ribbotson/EMG_ADS131M08/Kicad/ADS131M08 ESP32.kicad_pcb

## KiCad design Kicad/ADS131M08 ESP32.kicad_pcb (2023-05-13)

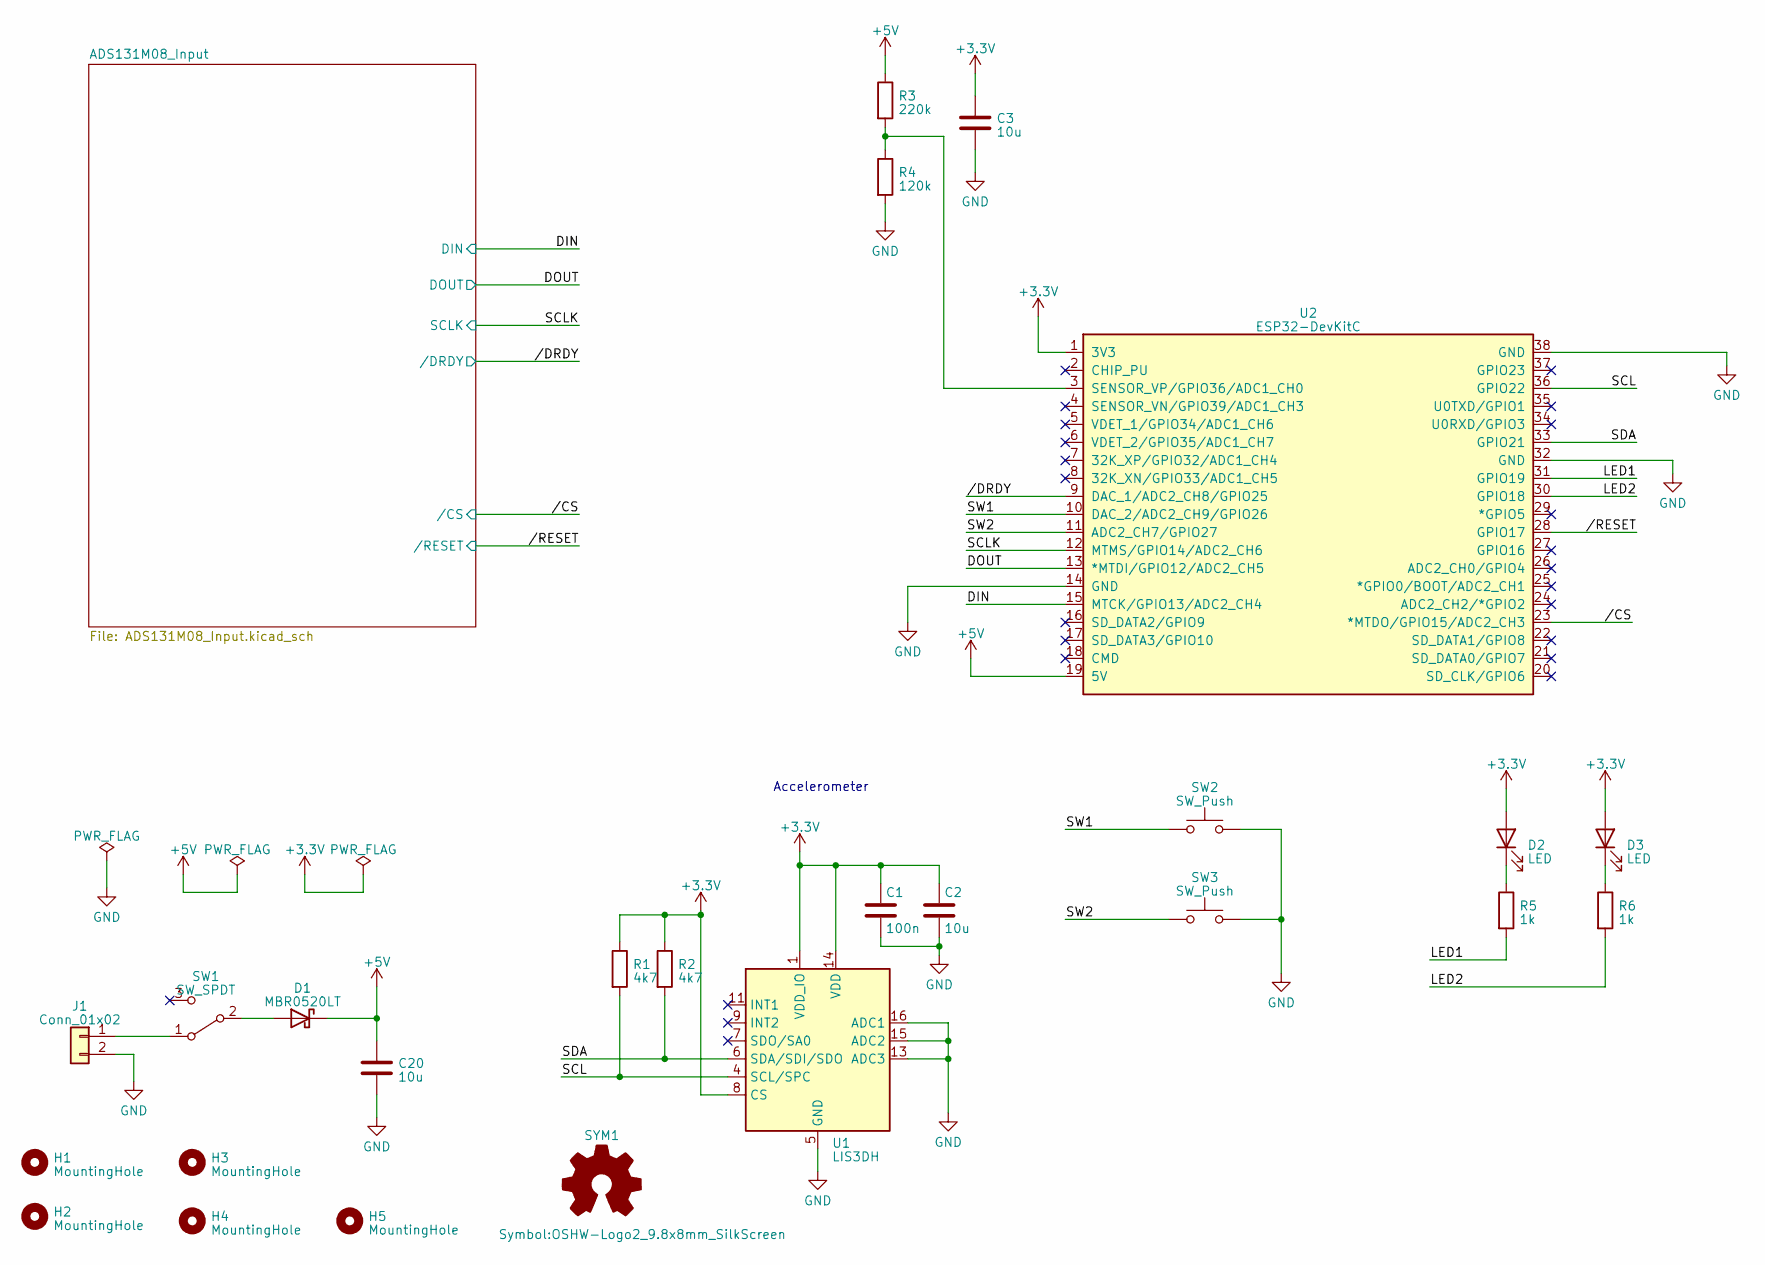
[picture p1: schematic ADS131M08 ESP32.kicad_sch]

Parts:
C1: 100n; C_0603_1608Metric
C2, C3, C20: 10u; C_0805_2012Metric
D1: MBR0520LT; D_SOD-123
D2, D3: LED; LED_0603_1608Metric
H1, H2, H3, H4, H5: MountingHole; MountingHole_2.2mm_M2
J1: Conn_01x02; JST_PH_S2B-PH-SM4-TB_1x02-1MP_P2.00mm_Horizontal
R1, R2: 4k7; R_0603_1608Metric
R3: 220k; R_0603_1608Metric
R4: 120k; R_0603_1608Metric
R5, R6: 1k; R_0603_1608Metric
SW1: SW_SPDT; SW_SPDT_CK-JS102011SAQN
SW2, SW3: SW_Push; SW_SPST_EVQP0
SYM1: Logo_Open_Hardware_Small; OSHW-Logo2_9.8x8mm_SilkScreen
U1: LIS3DH; LGA-16_3x3mm_P0.5mm_LayoutBorder3x5y
U2: ESP32-DevKitC

Connections:
+3.3V: C1.1, C2.1, C3.1, D2.2 (A), D3.2 (A), R1.1, R2.1, U1.1 (VDD_IO), U1.8 (CS), U1.14 (VDD), U2.1 (3V3); also elsewhere on the board
+5V: C20.1, D1.1 (K), R3.1, U2.19 (5V); also elsewhere on the board
/DIN: U2.15 (MTCK/GPIO13/ADC2_CH4); also elsewhere on the board
/DOUT: U2.13 (*MTDI/GPIO12/ADC2_CH5); also elsewhere on the board
/LED1: R5.2, U2.31 (GPIO19)
/LED2: R6.2, U2.30 (GPIO18)
/SCL: R1.2, U1.4 (SCL/SPC), U2.36 (GPIO22)
/SCLK: U2.12 (MTMS/GPIO14/ADC2_CH6); also elsewhere on the board
/SDA: R2.2, U1.6 (SDA/SDI/SDO), U2.33 (GPIO21)
/SW1: SW2.1, U2.10 (DAC_2/ADC2_CH9/GPIO26)
/SW2: SW3.1, U2.11 (ADC2_CH7/GPIO27)
//CS: U2.23 (*MTDO/GPIO15/ADC2_CH3); also elsewhere on the board
//DRDY: U2.9 (DAC_1/ADC2_CH8/GPIO25); also elsewhere on the board
//RESET: U2.28 (GPIO17); also elsewhere on the board
GND: C1.2, C2.2, C3.2, C20.2, J1.2, R4.2, SW2.2, SW3.2, U1.5 (GND), U1.10 (GND), U1.12 (GND), U1.13 (ADC3), U1.15 (ADC2), U1.16 (ADC1), U2.14 (GND), U2.32 (GND), U2.38 (GND); also elsewhere on the board
unnamed: D1.2 (A), SW1.2 (B)
unnamed: D2.1 (K), R5.1
unnamed: D3.1 (K), R6.1
unnamed: J1.1, SW1.1 (A)
unnamed: R3.2, R4.1, U2.3 (SENSOR_VP/GPIO36/ADC1_CH0)

Notes on the sheet:
Accelerometer

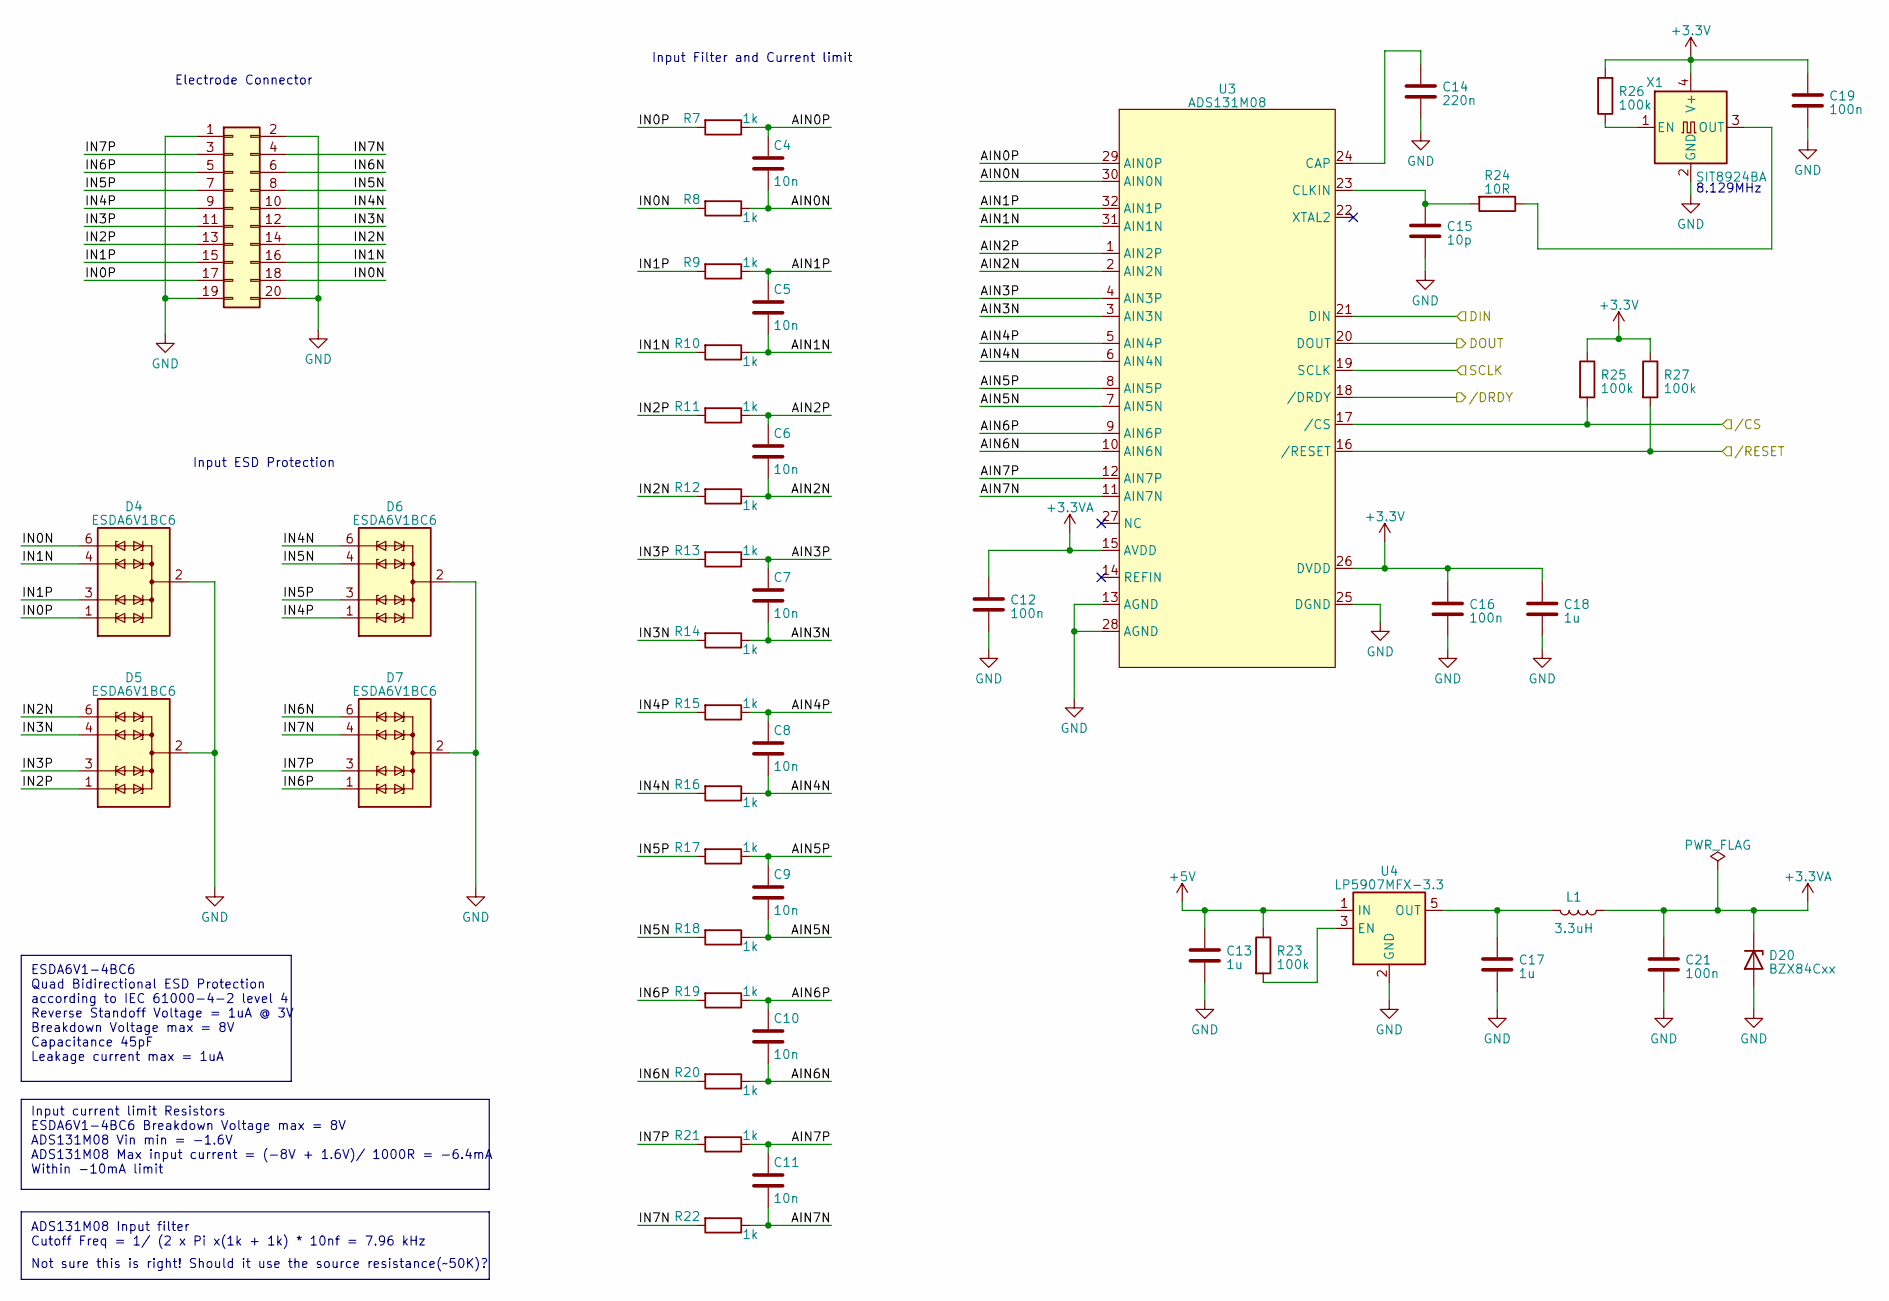
[picture p2: schematic ADS131M08_Input.kicad_sch]

Parts:
C4, C5, C6, C7, C8, C9, C10, C11: 10n; C_0603_1608Metric
C12, C16, C19, C21: 100n; C_0603_1608Metric
C13, C17, C18: 1u; C_0603_1608Metric
C14: 220n; C_0603_1608Metric
C15: 10p; C_0603_1608Metric
D4, D5, D6, D7: ESDA6V1BC6; SOT-23-6
D20: BZX84Cxx; SOT-23
J2: Conn_02x10_Odd_Even; PinHeader_2x10_P2.54mm_Horizontal
L1: 3.3uH; L_0603_1608Metric
R7, R8, R9, R10, R11, R12, R13, R14, R15, R16, R17, R18, R19, R20, R21, R22: 1k; R_0603_1608Metric
R23, R25, R26, R27: 100k; R_0603_1608Metric
R24: 10R; R_0603_1608Metric
U3: ADS131M08; PQFP-32_5x5mm_P0.5mm
U4: LP5907MFX-3.3; SOT-23-5
X1: SIT8924BA; Oscillator_SMD_EuroQuartz_XO32-4Pin_3.2x2.5mm

Connections:
+3.3V: C16.1, C18.1, C19.1, R25.1, R26.2, R27.1, U3.26 (DVDD), X1.4 (V+); also elsewhere on the board
+3.3VA: C12.1, C21.1, D20.3 (K), L1.1, U3.15 (AVDD)
+5V: C13.1, R23.1, U4.1 (IN); also elsewhere on the board
/ADS131M08_Input/AIN0N: C4.2, R8.1, U3.30 (AIN0N)
/ADS131M08_Input/AIN0P: C4.1, R7.1, U3.29 (AIN0P)
/ADS131M08_Input/AIN1N: C5.2, R10.1, U3.31 (AIN1N)
/ADS131M08_Input/AIN1P: C5.1, R9.1, U3.32 (AIN1P)
/ADS131M08_Input/AIN2N: C6.2, R12.1, U3.2 (AIN2N)
/ADS131M08_Input/AIN2P: C6.1, R11.1, U3.1 (AIN2P)
/ADS131M08_Input/AIN3N: C7.2, R14.1, U3.3 (AIN3N)
/ADS131M08_Input/AIN3P: C7.1, R13.1, U3.4 (AIN3P)
/ADS131M08_Input/AIN4N: C8.2, R16.1, U3.6 (AIN4N)
/ADS131M08_Input/AIN4P: C8.1, R15.1, U3.5 (AIN4P)
/ADS131M08_Input/AIN5N: C9.2, R18.1, U3.7 (AIN5N)
/ADS131M08_Input/AIN5P: C9.1, R17.1, U3.8 (AIN5P)
/ADS131M08_Input/AIN6N: C10.2, R20.1, U3.10 (AIN6N)
/ADS131M08_Input/AIN6P: C10.1, R19.1, U3.9 (AIN6P)
/ADS131M08_Input/AIN7N: C11.2, R22.1, U3.11 (AIN7N)
/ADS131M08_Input/AIN7P: C11.1, R21.1, U3.12 (AIN7P)
/ADS131M08_Input/IN0N: D4.6 (TVS4), J2.18, R8.2
/ADS131M08_Input/IN0P: D4.1 (TVS1), J2.17, R7.2
/ADS131M08_Input/IN1N: D4.4 (TVS3), J2.16, R10.2
/ADS131M08_Input/IN1P: D4.3 (TVS2), J2.15, R9.2
/ADS131M08_Input/IN2N: D5.6 (TVS4), J2.14, R12.2
/ADS131M08_Input/IN2P: D5.1 (TVS1), J2.13, R11.2
/ADS131M08_Input/IN3N: D5.4 (TVS3), J2.12, R14.2
/ADS131M08_Input/IN3P: D5.3 (TVS2), J2.11, R13.2
/ADS131M08_Input/IN4N: D6.6 (TVS4), J2.10, R16.2
/ADS131M08_Input/IN4P: D6.1 (TVS1), J2.9, R15.2
/ADS131M08_Input/IN5N: D6.4 (TVS3), J2.8, R18.2
/ADS131M08_Input/IN5P: D6.3 (TVS2), J2.7, R17.2
/ADS131M08_Input/IN6N: D7.6 (TVS4), J2.6, R20.2
/ADS131M08_Input/IN6P: D7.1 (TVS1), J2.5, R19.2
/ADS131M08_Input/IN7N: D7.4 (TVS3), J2.4, R22.2
/ADS131M08_Input/IN7P: D7.3 (TVS2), J2.3, R21.2
/DIN: U3.21 (DIN); also elsewhere on the board
/DOUT: U3.20 (DOUT); also elsewhere on the board
/SCLK: U3.19 (SCLK); also elsewhere on the board
//CS: R25.2, U3.17 (/CS); also elsewhere on the board
//DRDY: U3.18 (/DRDY); also elsewhere on the board
//RESET: R27.2, U3.16 (/RESET); also elsewhere on the board
GND: C12.2, C13.2, C14.2, C15.2, C16.2, C17.2, C18.2, C19.2, C21.2, D4.2 (COM), D4.5 (COM), D5.2 (COM), D5.5 (COM), D6.2 (COM), D6.5 (COM), D7.2 (COM), D7.5 (COM), D20.1 (A), J2.1, J2.2, J2.19, J2.20, U3.13 (AGND), U3.25 (DGND), U3.28 (AGND), U4.2 (GND), X1.2 (GND); also elsewhere on the board
unnamed: C14.1, U3.24 (CAP)
unnamed: C15.1, R24.2, U3.23 (CLKIN)
unnamed: R23.2, U4.3 (EN)
unnamed: C17.1, L1.2, U4.5 (OUT)
unnamed: R26.1, X1.1 (EN)
unnamed: R24.1, X1.3 (OUT)

Notes on the sheet:
ESDA6V1-4BC6 Quad Bidirectional ESD Protection according to IEC 61000-4-2 level 4 Reverse Standoff Voltage = 1uA @ 3V Breakdown Voltage max = 8V Capacitance 45pF Leakage current max = 1uA
Input Filter and Current limit
Input ESD Protection
8.129MHz
Not sure this is right! Should it use the source resistance(~50K)?
ADS131M08 Input filter Cutoff Freq = 1/ (2 x Pi x(1k + 1k) * 10nf = 7.96 kHz
Electrode Connector
Input current limit Resistors ESDA6V1-4BC6 Breakdown Voltage max = 8V ADS131M08 Vin min = -1.6V ADS131M08 Max input current = (-8V + 1.6V)/ 1000R = -6.4mA Within -10mA limit

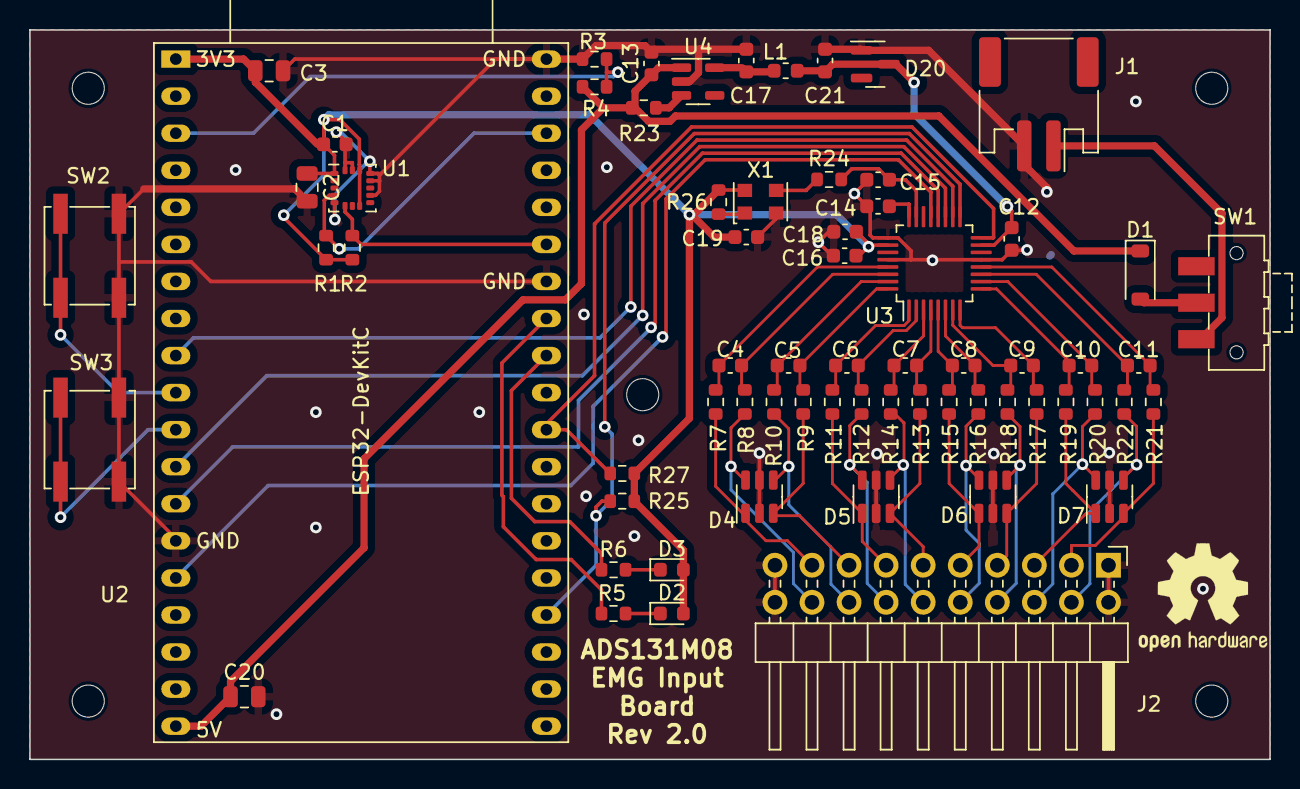
[picture p3: board ADS131M08 ESP32.kicad_pcb from above]

Board: 2 copper layers, 85.0 x 50.0 mm, 73 parts (0 on the bottom side), 59 nets.
