ribbotson/EMG_ADS131M08/(commit log)

2023-03-07 Update ADS131M08 ESP32.kicad_pcb
    [ADS131M08 ESP32.kicad_pcb]
2023-04-21 Fix PCB Issues
    Fix ADS131M08 Pinout
    Fix ADS131M08 footprint size
    Replace tiny ESD devices
    [ADS131M08 ESP32.kicad_pcb, ADS131M08_Input.kicad_sch]
2023-04-27 New Gerbers
    [ADS131M08 ESP32-B_Cu.gbr, ADS131M08 ESP32-B_Mask.gbr, ADS131M08 ESP32-B_Paste.gbr, ADS131M08 ESP32-B_Silkscreen.gbr, ADS131M08 ESP32-Edge_Cuts.gbr, ADS131M08 ESP32-F_Cu.gbr, ADS131M08 ESP32-F_Mask.gbr, ADS131M08 ESP32-F_Paste.gbr]
